Anteater-Electric-Racing/Precharge-Circuit/README.md

# [Schematic Preview](https://kicanvas.org/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)
