Anteater-Electric-Racing/Precharge-Circuit/pcc_v0.2.step

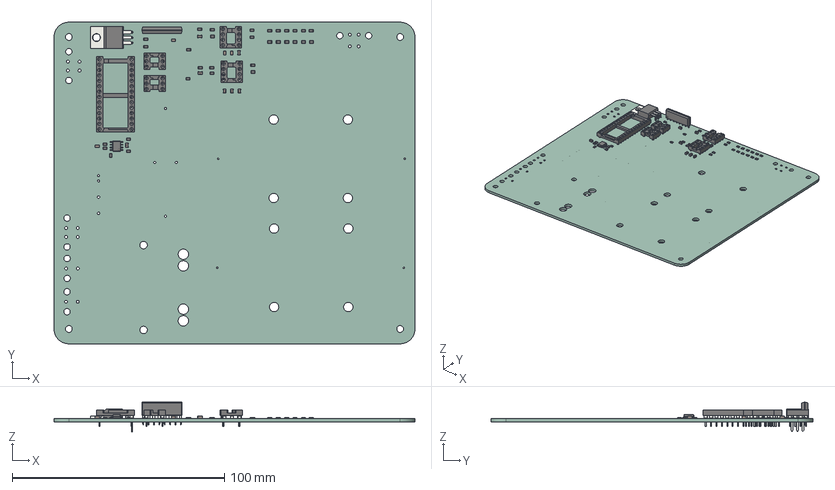
[picture p1: CAD file, 2026-01-10]
pcc_v0.2.step
170.3 x 151.7 x 14.0 mm
C_0805_2012Metric x 11
R_0805_2012Metric x 31
DIP_28_W1524mm_Socket
SOIC_8_39x49mm_P127mm
SIP-8_19x3mm_P2.54mm
DIP_6_W762mm_Socket x 2
DIP_8_W762mm_Socket x 2
TO-220-3_Horizontal_TabDown
pcc_v0.1_PCB
