Anteater-Electric-Racing/Precharge-Circuit/pcc_v0.2.kicad_pcb

## KiCad design pcc_v0.2.kicad_pcb (2026-03-03)

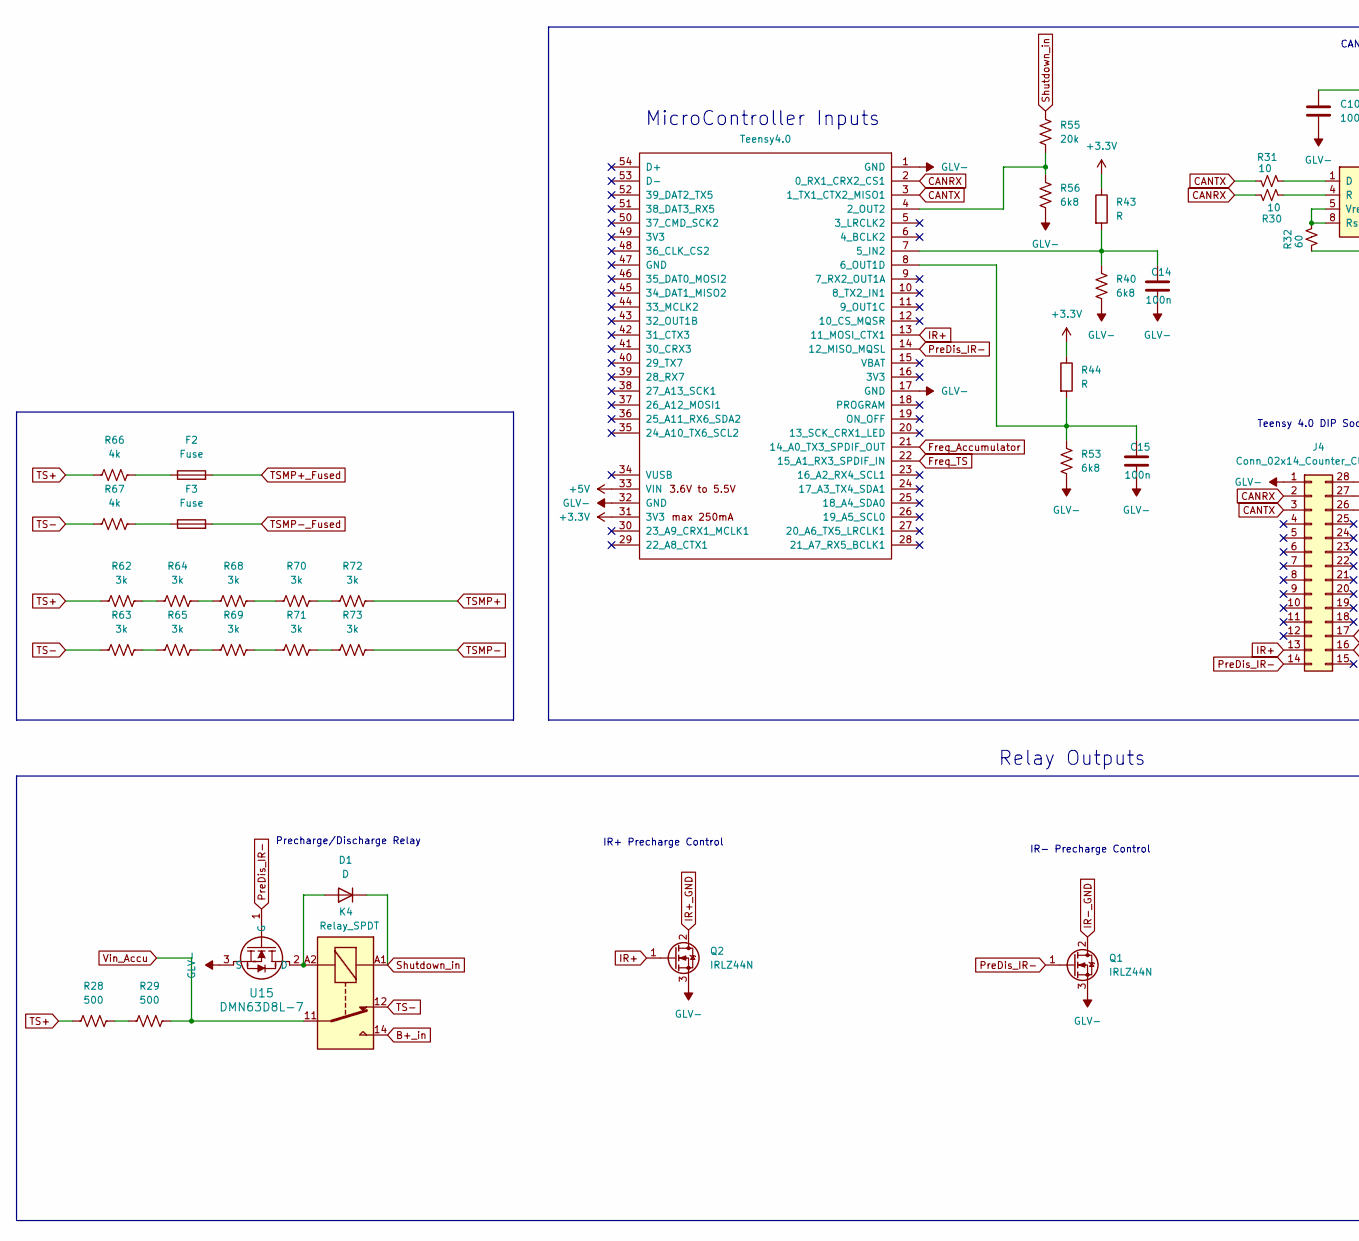
[picture p2: schematic pcc_v0.2.kicad_sch, Precharge Circuit, part in row 1, column 1]

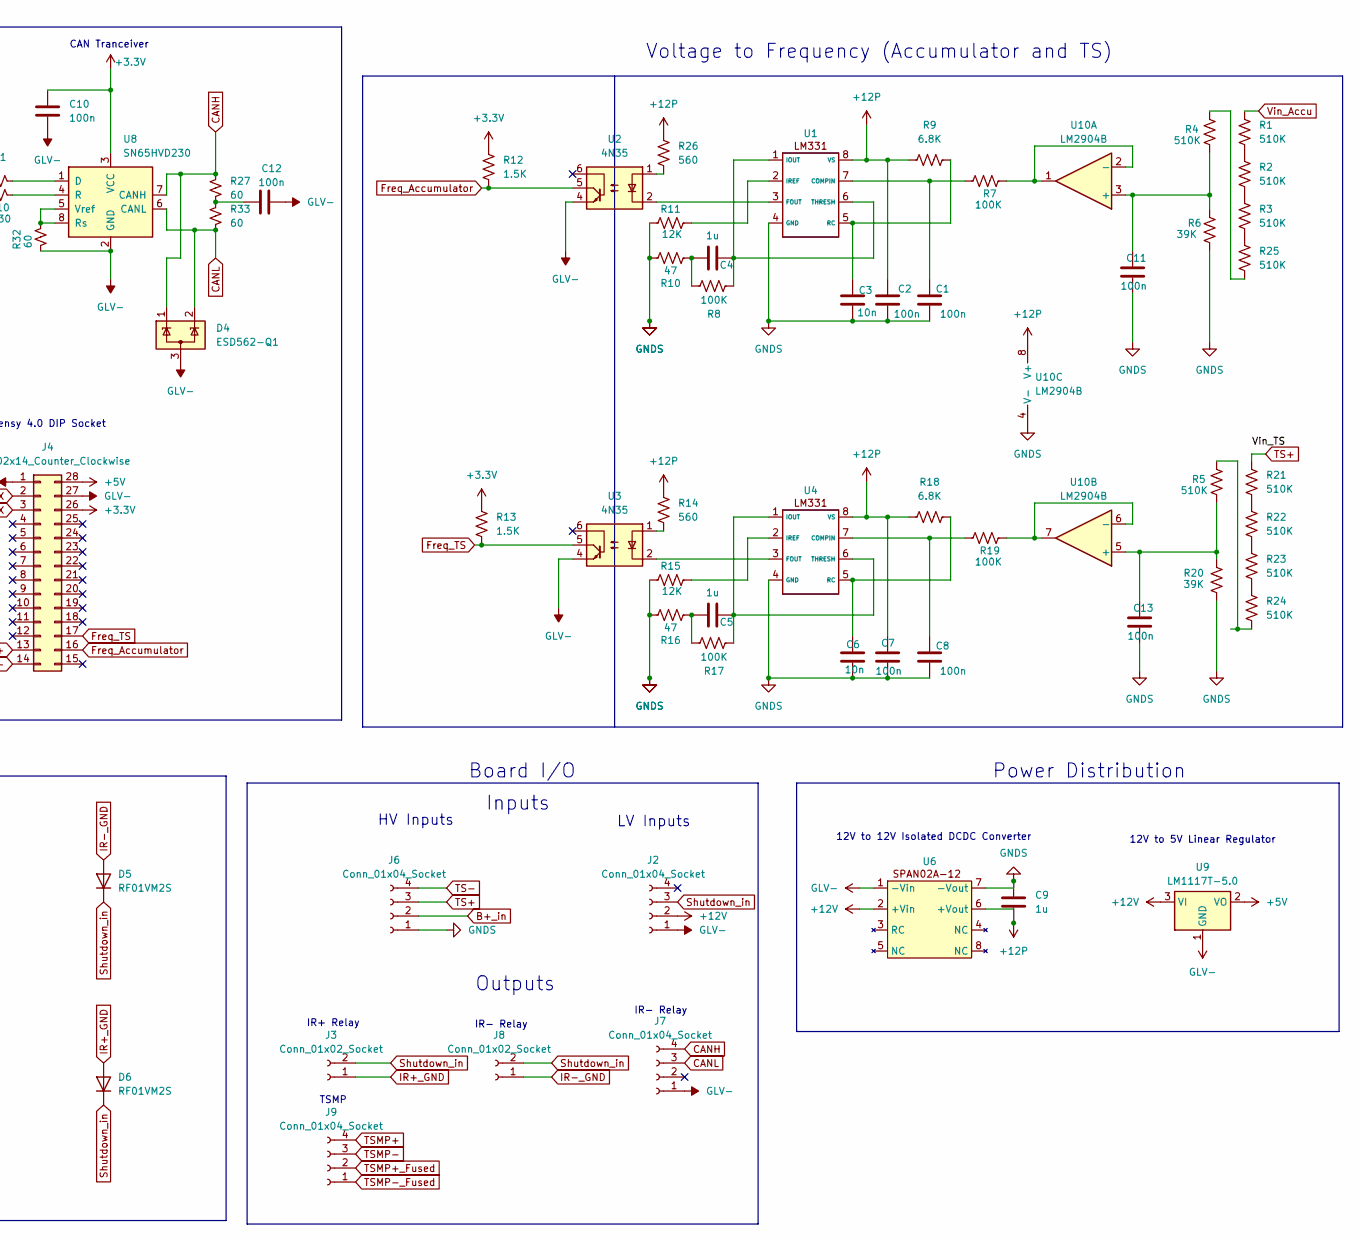
[picture p3: schematic pcc_v0.2.kicad_sch, Precharge Circuit, part in row 1, column 2]

Parts:
C1, C2, C7, C8, C10, C11, C12, C13, C14, C15: 100n; C_0805_2012Metric
C3, C6: 10n; C_0805_2012Metric
C4, C5, C9: 1u; C_0805_2012Metric
D1: D; D_5KPW_P7.62mm_Vertical_AnodeUp
D4: ESD562-Q1; SOT-23-3
D5, D6: RF01VM2S; D_SOD-323
F2, F3: Fuse; Fuse_1206_3216Metric
J2, J6, J7, J9: Conn_01x04_Socket; Molex_Mini-Fit_Jr_5566-04A2_2x02_P4.20mm_Vertical
J3, J8: Conn_01x02_Socket; Molex_Mini-Fit_Jr_5566-02A2_2x01_P4.20mm_Vertical
J4: Conn_02x14_Counter_Clockwise; DIP-28_W15.24mm_Socket
K4: Relay_SPDT; Precharge_Discharge_Relay
Q1, Q2: IRLZ44N; TO-220-3_Vertical
R1, R2, R3, R4, R5, R21, R22, R23, R24, R25: 510K; R_0805_2012Metric
R6, R20: 39K; R_0805_2012Metric
R7, R8, R17, R19: 100K; R_0805_2012Metric
R9, R18: 6.8K; R_0805_2012Metric
R10, R16: 47; R_0805_2012Metric
R11, R15: 12K; R_0805_2012Metric
R12, R13: 1.5K; R_0805_2012Metric
R14, R26: 560; R_0805_2012Metric
R27, R32, R33: 60; R_0805_2012Metric
R28, R29: 500; Ohmite HS100 500R F
R30, R31: 10; R_0805_2012Metric
R40, R53, R56: 6k8; R_0805_2012Metric
R43, R44: R; PinSocket_1x02_P2.00mm_Vertical
R55: 20k; R_0805_2012Metric
R62, R63, R64, R65, R68, R69, R70, R71, R72, R73: 3k; R_2512_6332Metric
R66, R67: 4k; R_0805_2012Metric
U1, U4: DIP-8_W7.62mm_Socket
U2, U3: 4N35; DIP-6_W7.62mm_Socket
U6: SIP-8_19x3mm_P2.54mm
U7: Teensy4.0; DIP-28_W15.24mm_Socket
U8: SN65HVD230; SOIC-8_3.9x4.9mm_P1.27mm
U9: LM1117T-5.0; TO-220-3_Horizontal_TabDown
U10: LM2904B; SOIC-8_3.9x4.9mm_P1.27mm
U15: DMN63D8L-7; SOIC_63D8L-7_DIO

Connections:
+3.3V: C10.1, J4.26, R12.2, R13.2, R43.1, R44.1, U7.31 (3V3), U8.3 (VCC)
+5V: J4.28, U7.33 (VIN), U9.2 (VO)
+12P: C2.1, C7.1, C9.2, R9.1, R14.1, R18.1, R26.1, U1.8 (VS), U4.8 (VS), U6.6 (+Vout), U10.8 (V+)
+12V: J2.2, U6.2 (+Vin), U9.3 (VI)
B+_in: J6.2, K4.14
CANH: D4.1 (K), J7.4, R27.1, U8.7 (CANH)
CANL: D4.2 (K), J7.3, R33.2, U8.6 (CANL)
CANRX: J4.2, R30.1, U7.2 (0_RX1_CRX2_CS1)
CANTX: J4.3, R31.2, U7.3 (1_TX1_CTX2_MISO1)
Freq_Accumulator: J4.16, R12.1, U2.5, U7.21 (14_A0_TX3_SPDIF_OUT)
Freq_TS: J4.17, R13.1, U3.5, U7.22 (15_A1_RX3_SPDIF_IN)
GLV-: C10.2, C12.2, C14.2, C15.2, D4.3 (A), J2.1, J4.1, J4.27, J7.1, Q1.3 (S), Q2.3 (S), R32.2, R40.2, R53.2, R56.2, U2.4, U3.4, U6.1 (-Vin), U7.1 (GND), U7.17 (GND), U7.32 (GND), U8.2 (GND), U9.1 (GND), U15.3 (S)
GNDS: C1.2, C2.2, C3.2, C6.2, C7.2, C8.2, C9.1, C11.2, C13.2, J6.1, R6.2, R10.2, R11.1, R15.1, R16.2, R20.2, U1.4 (GND), U4.4 (GND), U6.7 (-Vout), U10.4 (V-)
IR+: J4.13, Q2.1 (G), U7.13 (11_MOSI_CTX1)
IR+_GND: D6.2 (A), J3.1, Q2.2 (D)
IR-_GND: D5.2 (A), J8.1, Q1.2 (D)
unnamed: C4.1, R8.1, R10.1
unnamed: C5.1, R16.1, R17.1
unnamed: C12.1, R27.2, R33.1
unnamed: C14.1, R40.1, R43.2, U7.7 (5_IN2)
unnamed: C15.1, R44.2, R53.1, U7.8 (6_OUT1D)
unnamed: D1.2 (A), K4.A2, U15.2 (D)
unnamed: F2.1, R66.1
unnamed: F3.1, R67.1
unnamed: R1.2, R2.1
unnamed: R2.2, R3.1
unnamed: R14.2, U3.1
unnamed: R21.2, R22.1
unnamed: R22.2, R23.1
unnamed: R23.2, R24.1
unnamed: R5.1, R24.2
unnamed: R3.2, R25.1
unnamed: R4.1, R25.2
unnamed: R26.2, U2.1
unnamed: R28.2, R29.1
unnamed: R55.2, R56.1, U7.4 (2_OUT2)
unnamed: R62.2, R64.1
unnamed: R63.2, R65.1
unnamed: R64.2, R68.1
unnamed: R65.2, R69.1
unnamed: R68.2, R70.1
unnamed: R69.2, R71.1
unnamed: R70.2, R72.1
unnamed: R71.2, R73.1
unnamed: C1.1, R7.1, U1.7 (COMPIN)
unnamed: U1.3 (FOUT), U2.2
unnamed: C4.2, R8.2, U1.1 (IOUT), U1.6 (THRESH)
unnamed: R11.2, U1.2 (IREF)
unnamed: C3.1, R9.2, U1.5 (RC)
unnamed: C8.1, R19.1, U4.7 (COMPIN)
unnamed: U3.2, U4.3 (FOUT)
unnamed: C5.2, R17.2, U4.1 (IOUT), U4.6 (THRESH)
unnamed: R15.2, U4.2 (IREF)
unnamed: C6.1, R18.2, U4.5 (RC)
unnamed: R31.1, U8.1 (D)
unnamed: R30.2, U8.4 (R)
unnamed: R32.1, U8.5 (Vref), U8.8 (Rs)
unnamed: C11.1, R4.2, R6.1, U10.3 (+)
unnamed: R7.2, U10.1, U10.2 (-)
unnamed: C13.1, R5.2, R20.1, U10.5 (+)
unnamed: R19.2, U10.6 (-), U10.7
PreDis_IR-: J4.14, Q1.1 (G), U7.14 (12_MISO_MQSL), U15.1 (G)
Shutdown_in: D1.1 (K), D5.1 (K), D6.1 (K), J2.3, J3.2, J8.2, K4.A1, R55.1
TS+: J6.3, R21.1, R28.1, R62.1, R66.2
TS-: J6.4, K4.12, R63.1, R67.2
TSMP+: J9.4, R72.2
TSMP+_Fused: F2.2, J9.2
TSMP-: J9.3, R73.2
TSMP-_Fused: F3.2, J9.1
Vin_Accu: K4.11, R1.1, R29.2

Notes on the sheet:
Board I/O
TSMP
HV Inputs
Inputs
IR+ Relay
LV Inputs
Teensy 4.0 DIP Socket
IR- Precharge Control
Voltage to Frequency (Accumulator and TS)
MicroController Inputs
IR- Relay
Relay Outputs
CAN Tranceiver
Precharge/Discharge Relay
IR+ Precharge Control
Outputs
Power Distribution
12V to 5V Linear Regulator
12V to 12V Isolated DCDC Converter

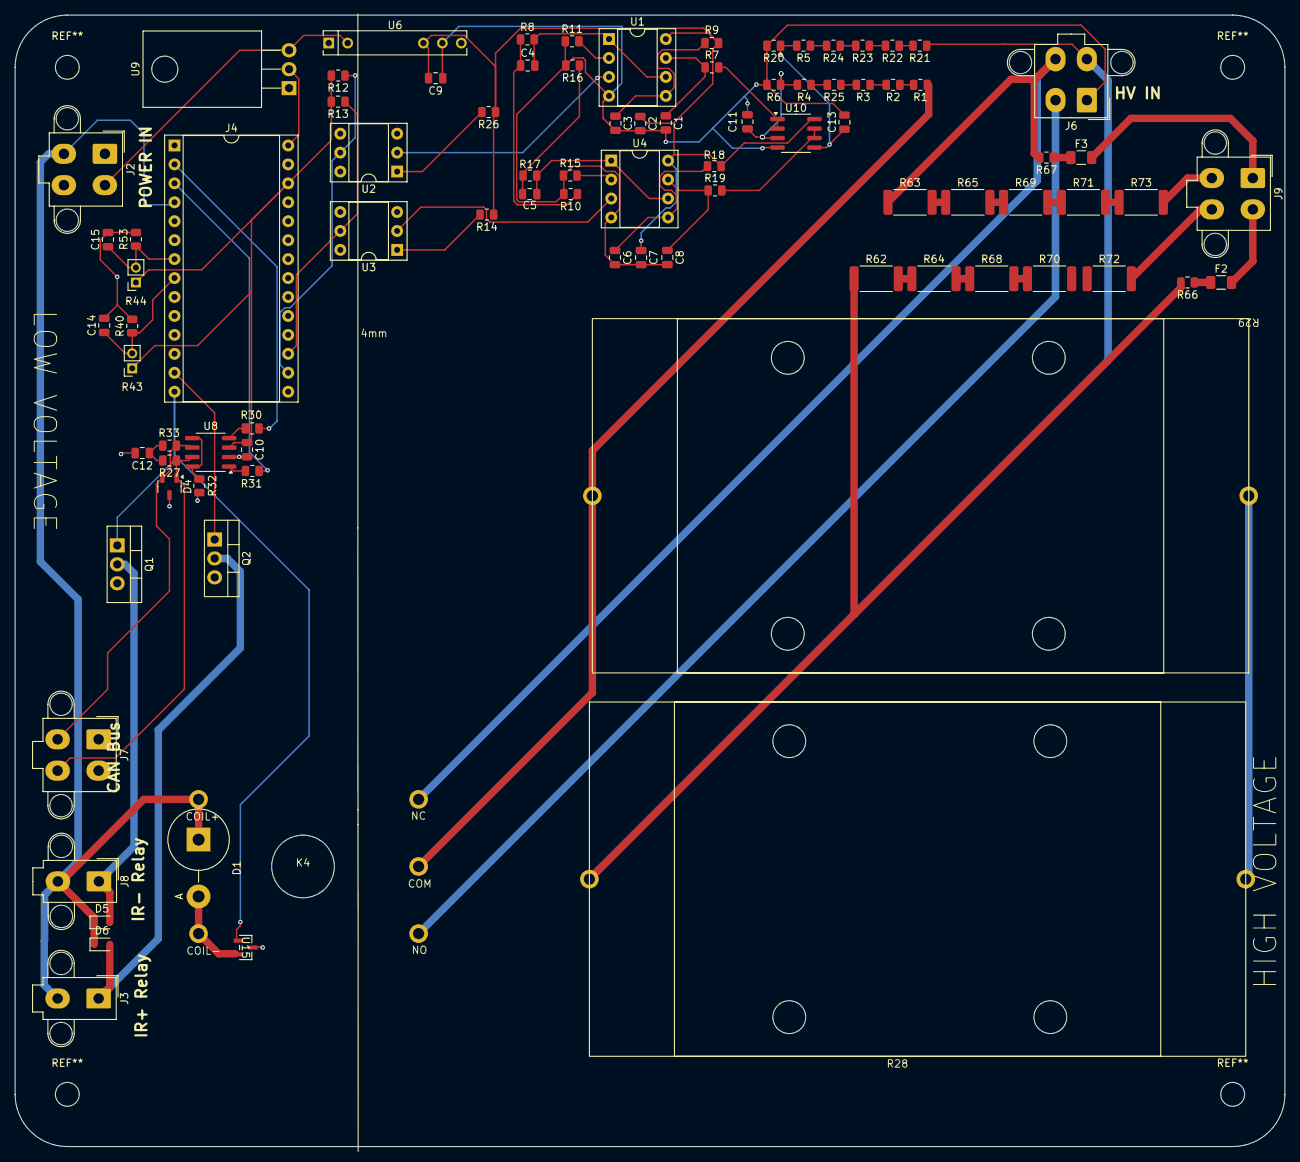
[picture p4: board pcc_v0.2.kicad_pcb from above]

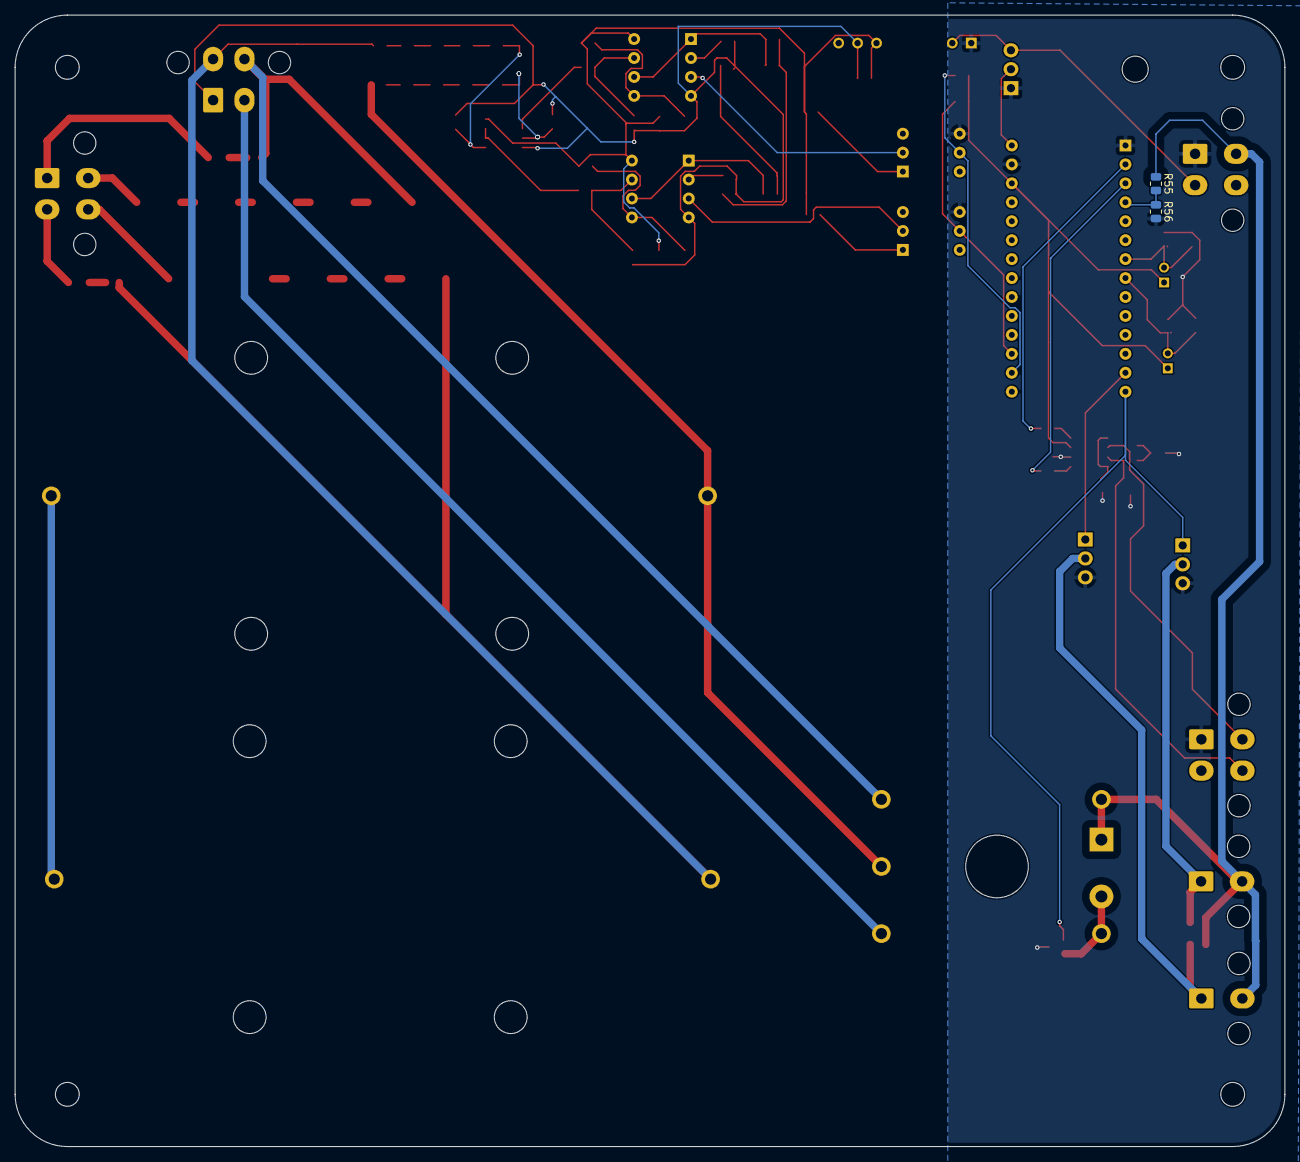
[picture p5: board pcc_v0.2.kicad_pcb from below]

Board: 2 copper layers, 170.3 x 151.7 mm, 91 parts (2 on the bottom side), 70 nets.
