Anteater-Electric-Racing/Precharge-Circuit/(commit log)

2024-12-03 pcc merge inputs and v-f
    [pcc_v0.1.kicad_pcb, pcc_v0.1.kicad_sch]
2024-12-03 Update schematic preview in readme
2024-12-05 add img preview
    [pcc_v0.1.kicad_sch]
2024-12-05 show LV/HV isolation
    [pcc_v0.1.kicad_sch]
2025-01-23 pcc modifications
    [pcc_v0.1.kicad_sch]
2025-01-24 started pcb layout
    [pcc_v0.1.kicad_pcb, pcc_v0.1.kicad_sch]
2025-01-26 polishing layout
    [pcc_v0.1.kicad_pcb, pcc_v0.1.kicad_sch]
2025-01-27 cleaned up layout
    [pcc_v0.1.kicad_pcb, pcc_v0.1.kicad_sch]
2025-01-28 revised with all relay outputs
    [pcc_v0.1.kicad_pcb, pcc_v0.1.kicad_sch]
2025-01-29 looking to add discharge relay
    [pcc_v0.1.kicad_pcb, pcc_v0.1.kicad_sch]
2025-02-01 routed pcb
    [pcc_v0.1.kicad_pcb, pcc_v0.1.kicad_sch]
2025-02-10 next round of changes with correct precharge resistor and isolation distance
    [pcc_v0.1.kicad_pcb, pcc_v0.1.kicad_sch]
2025-02-12 next round of edits
    [pcc_v0.1.kicad_pcb, pcc_v0.1.kicad_sch]
2025-02-13 can tranceiver filtering stuff
    [pcc_v0.1.kicad_pcb, pcc_v0.1.kicad_sch]
2025-02-13 added discharge relay
    [pcc_v0.1.kicad_pcb, pcc_v0.1.kicad_sch]
2025-02-13 fixed text placement
    [pcc_v0.1.kicad_pcb, pcc_v0.1.kicad_sch]
2025-02-14 generated bom
    [pcc_v0.1.kicad_pcb, pcc_v0.1.kicad_sch]
2025-02-18 generated gerbers
    [pcc_v0.1-B_Cu.gbr, pcc_v0.1-B_Mask.gbr, pcc_v0.1-B_Paste.gbr, pcc_v0.1-B_Silkscreen.gbr, pcc_v0.1-Edge_Cuts.gbr, pcc_v0.1-F_Cu.gbr, pcc_v0.1-F_Mask.gbr, pcc_v0.1-F_Paste.gbr]
2026-01-10 Add PCC version 2
    [pcc_v0.2.csv, pcc_v0.2.kicad_pcb, pcc_v0.2.kicad_sch, pcc_v0.2.step]
2026-03-04 Removed v1
    [pcc_v0.1-B_Cu.gbr, pcc_v0.1-B_Mask.gbr, pcc_v0.1-B_Paste.gbr, pcc_v0.1-B_Silkscreen.gbr, pcc_v0.1-Edge_Cuts.gbr, pcc_v0.1-F_Cu.gbr, pcc_v0.1-F_Mask.gbr, pcc_v0.1-F_Paste.gbr]
